yschaeff/raddr_switch/raddr.kicad_pcb

## KiCad design raddr.kicad_pcb (2024-10-31)

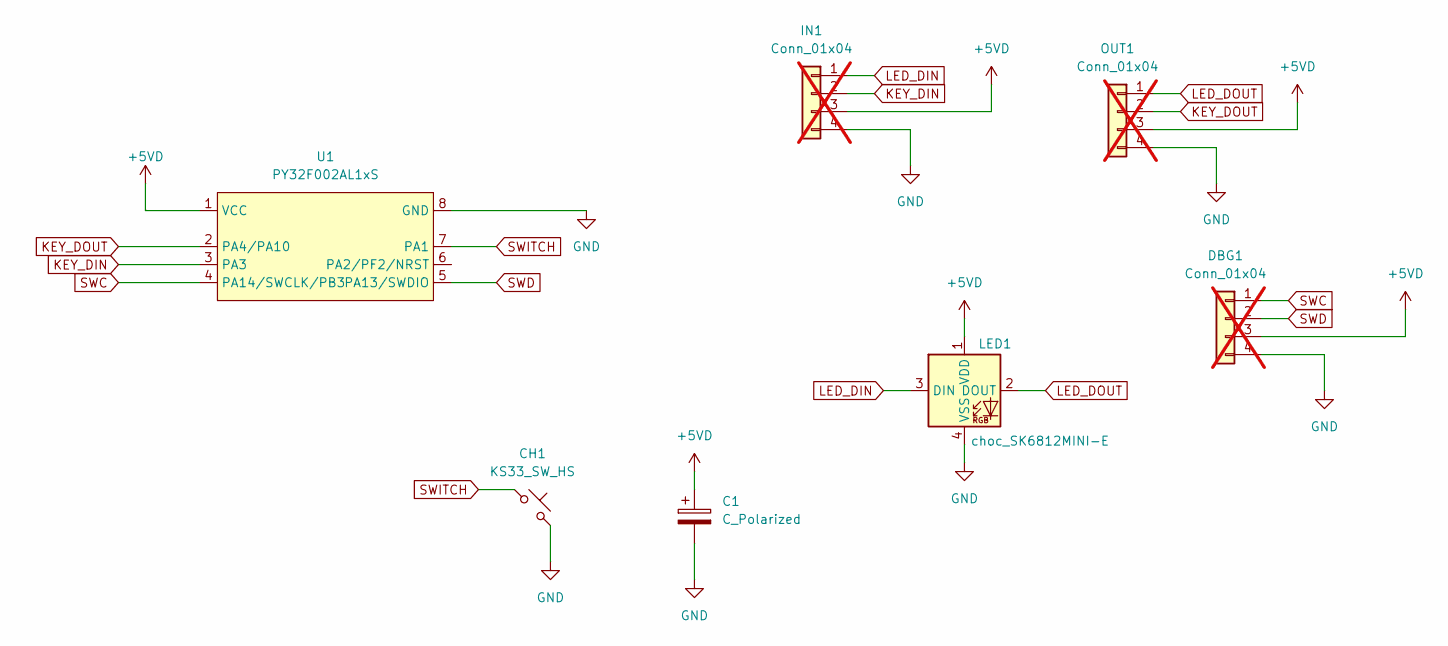
[picture p1: schematic raddr.kicad_sch]

Parts:
C1: C_Polarized; C_0603_1608Metric_Pad1.08x0.95mm_HandSolder
CH1: KS33_SW_HS; SW_KS33_HS_KS-2P02B01-02_HS_1u
DBG1: Conn_01x04; PinSocket_1x04_P2.54mm_Vertical; not fitted
IN1: Conn_01x04; PinSocket_1x04_P2.54mm_Vertical; not fitted
LED1: choc_SK6812MINI-E; LED_choc_6028R
OUT1: Conn_01x04; PinSocket_1x04_P2.54mm_Vertical; not fitted
U1: PY32F002AL1xS; SOP-8_3.9x4.9mm_P1.27mm

Connections:
+5VD: C1.1, DBG1.3, IN1.3, LED1.1 (VDD), OUT1.3, U1.1 (VCC)
GND: C1.2, CH1.2, DBG1.4, IN1.4, LED1.4 (VSS), OUT1.4, U1.8 (GND)
KEY_DIN: IN1.2, U1.3 (PA3)
KEY_DOUT: OUT1.2, U1.2 (PA4/PA10)
LED_DIN: IN1.1, LED1.3 (DIN)
LED_DOUT: LED1.2 (DOUT), OUT1.1
SWC: DBG1.1, U1.4 (PA14/SWCLK/PB3)
SWD: DBG1.2, U1.5 (PA13/SWDIO)
SWITCH: CH1.1, U1.7 (PA1)

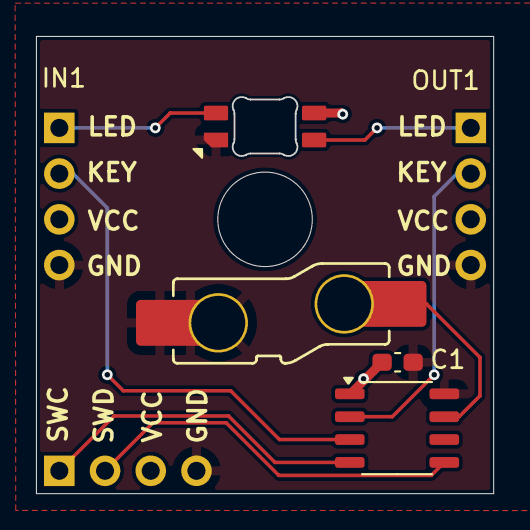
[picture p2: board raddr.kicad_pcb from above]

Board: 2 copper layers, 25.4 x 25.4 mm, 7 parts (0 on the bottom side), 9 nets.
