yschaeff/raddr_switch/(commit log)

2024-09-10 empty project
    [raddr.kicad_pcb, raddr.kicad_sch]
2024-09-10 Place all components
    [raddr.kicad_sch]
2024-09-11 add traces
    [raddr.kicad_pcb, raddr.kicad_sch]
2024-09-11 Muck around about traces
    [raddr.kicad_pcb, raddr.kicad_sch]
2024-09-12 WFP correction factor
    [raddr.kicad_pcb, raddr.kicad_sch]
2024-09-12 Add design rules.
    Took them from: https://github.com/labtroll/KiCad-DesignRules/tree/main/JLCPCB
2024-09-12 split connector
    [raddr.kicad_pcb, raddr.kicad_sch]
2024-09-12 silk screen
    [raddr.kicad_pcb, raddr.kicad_sch]
2024-09-14 Silk screen adjustments.
    [raddr.kicad_pcb, raddr.kicad_sch]
2024-09-14 overhaul
    - Align on grid
    - fillet
    - shring X dim
    - center button
    - remove extra bttn holes
    [raddr.kicad_pcb, raddr.kicad_sch]
2024-09-14 Mark pads as catellated
    [raddr.kicad_pcb]
2024-09-14 No CourtYard no problems!
    [raddr.kicad_pcb]
2024-09-15 Also mark single pins at the bottom as DNP
    [raddr.kicad_sch]
2024-09-15 Increase distance of board perimeter to pad to eliminate warning.
    [raddr.kicad_pcb]
2024-09-15 Fix thermal relieve issues by rotating spokes for pins near board edge.
    [raddr.kicad_pcb]
2024-10-30 fix power plane
    [raddr.kicad_pcb]
2024-10-31 silk screen and stuff
    [raddr.kicad_pcb]
